TudorVisan/VasileBOT/hardware/README

v1.0
    - Complete BOM available at
      https://docs.google.com/spreadsheets/d/1lKYWt8WgzWd33CoD_yIm1lVHJigqv4kNXPXV9A-a3yk/edit?usp=sharing
