TudorVisan/VasileBOT/hardware/sensorboard.brd

## EAGLE design hardware/sensorboard.brd (2016-12-20)

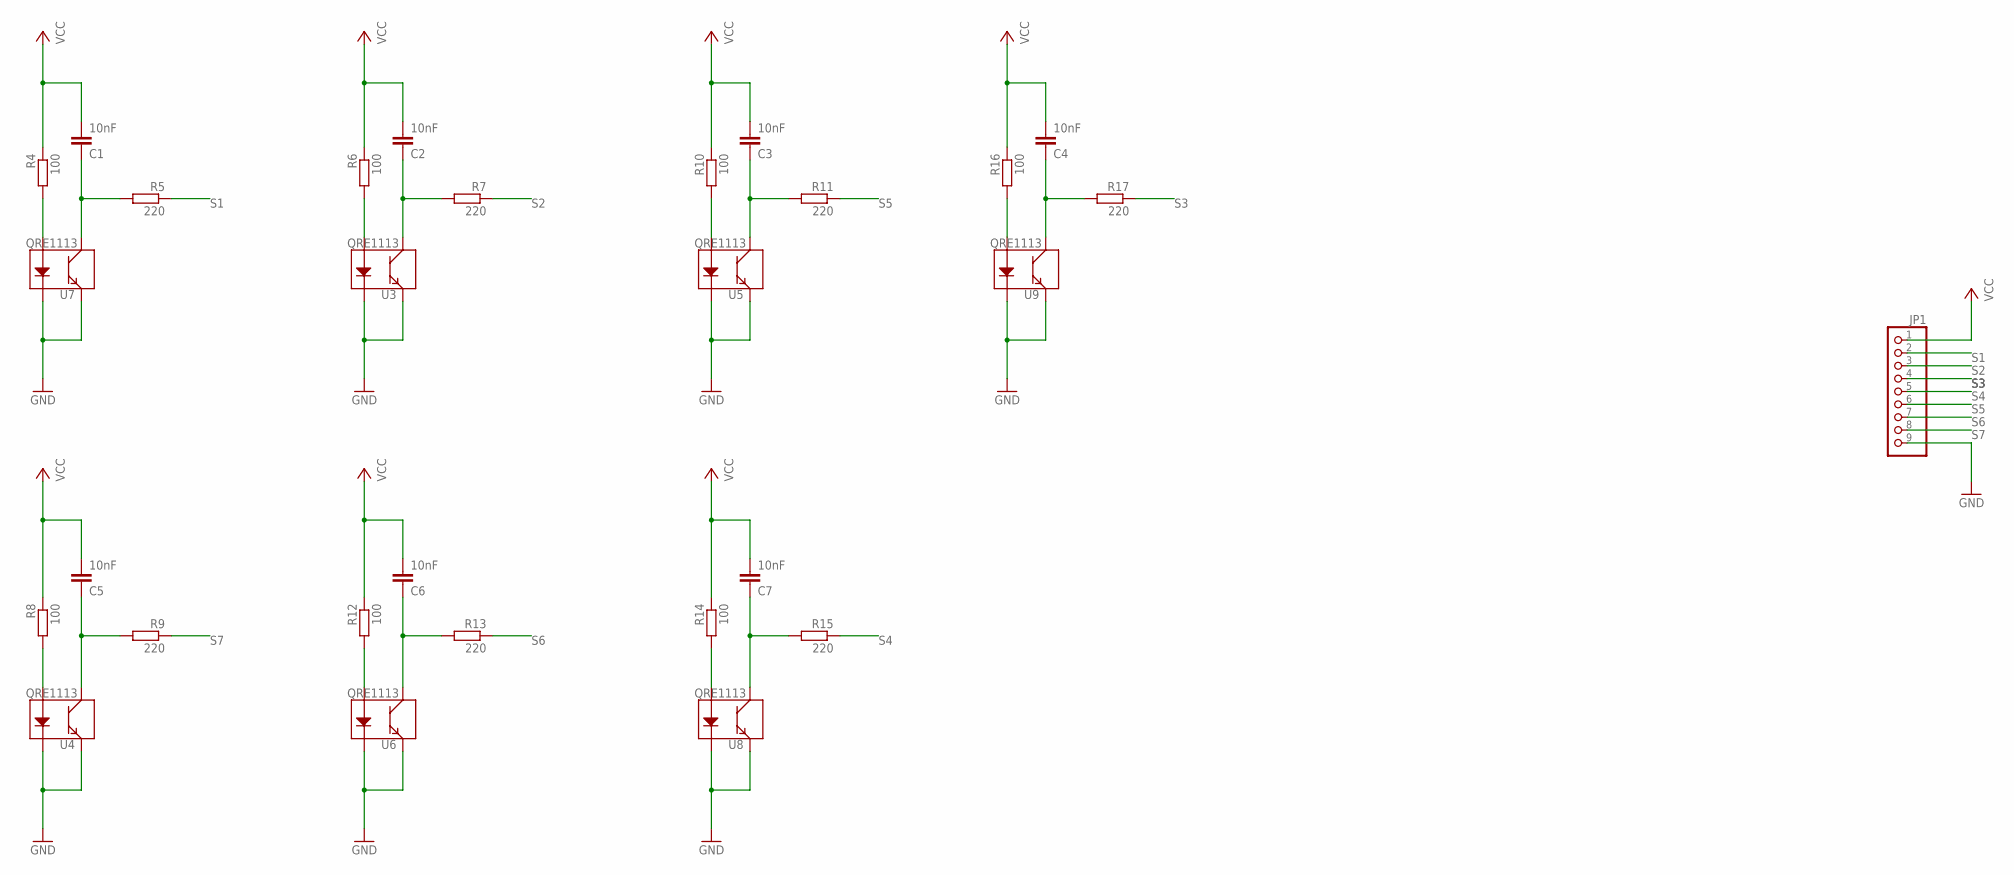
[picture p1: schematic sensorboard.sch]

Parts:
C1, C2, C3, C4, C5, C6, C7: 10nF; C0805K
JP1: PINHD-1X9; 1X09
R4, R6, R8, R10, R12, R14, R16: 100; M0805
R5, R7, R9, R11, R13, R15, R17: 220; M0805
U3, U4, U5, U6, U7, U8, U9: QRE1113

Connections:
GND: JP1.9, U3.2 (K), U3.4 (E), U4.2 (K), U4.4 (E), U5.2 (K), U5.4 (E), U6.2 (K), U6.4 (E), U7.2 (K), U7.4 (E), U8.2 (K), U8.4 (E), U9.2 (K), U9.4 (E)
unnamed: C1.1, R5.2, U7.3 (C)
unnamed: C2.1, R7.2, U3.3 (C)
unnamed: C3.1, R11.2, U5.3 (C)
unnamed: C4.1, R17.2, U9.3 (C)
unnamed: C7.1, R15.2, U8.3 (C)
unnamed: C6.1, R13.2, U6.3 (C)
unnamed: C5.1, R9.2, U4.3 (C)
unnamed: R4.2, U7.1 (A)
unnamed: R6.2, U3.1 (A)
unnamed: R8.2, U4.1 (A)
unnamed: R10.2, U5.1 (A)
unnamed: R12.2, U6.1 (A)
unnamed: R14.2, U8.1 (A)
unnamed: R16.2, U9.1 (A)
S1: JP1.2, R5.1
S2: JP1.3, R7.1
S3: JP1.4, R17.1
S4: JP1.5, R15.1
S5: JP1.6, R11.1
S6: JP1.7, R13.1
S7: JP1.8, R9.1
VCC: C1.2, C2.2, C3.2, C4.2, C5.2, C6.2, C7.2, JP1.1, R4.1, R6.1, R8.1, R10.1, R12.1, R14.1, R16.1

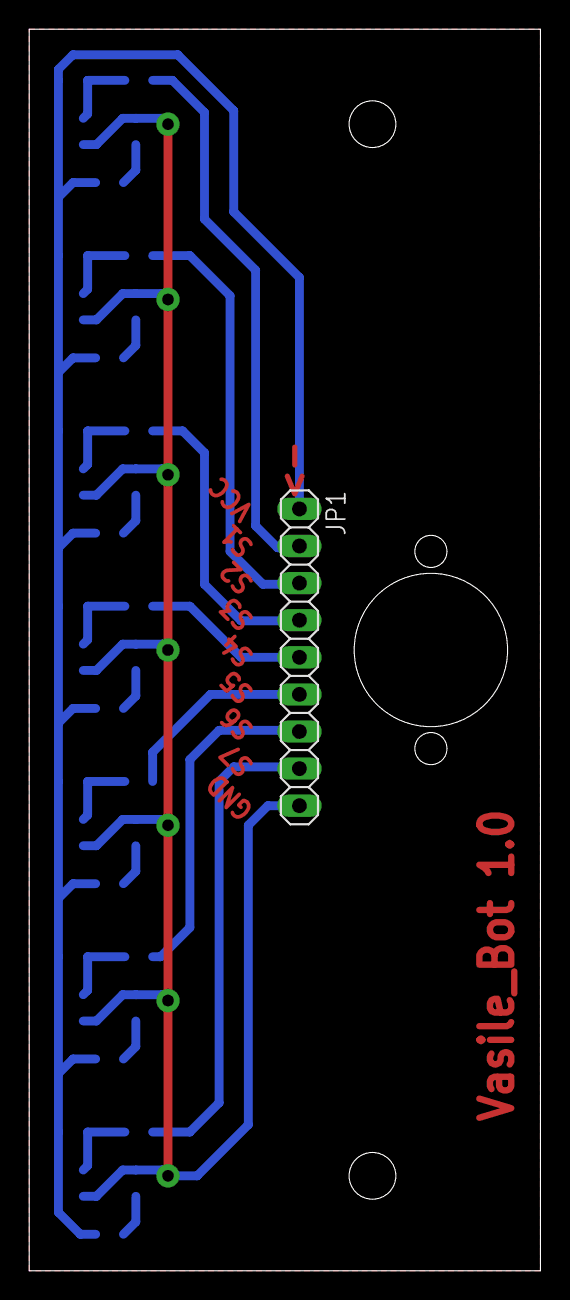
[picture p2: board sensorboard.brd from above]

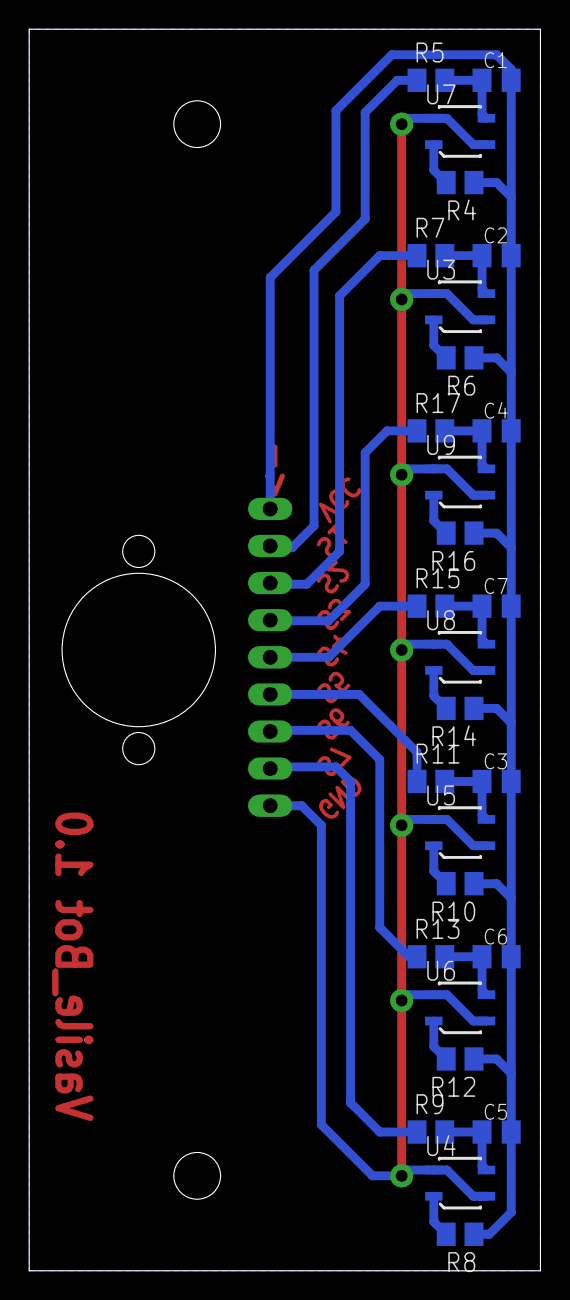
[picture p3: board sensorboard.brd from below]

Board: 2 copper layers, 35.0 x 85.0 mm, 29 parts (28 on the bottom side), 23 nets.
