TudorVisan/VasileBOT/hardware/motherboard.brd

## EAGLE design hardware/motherboard.brd (2016-12-20)

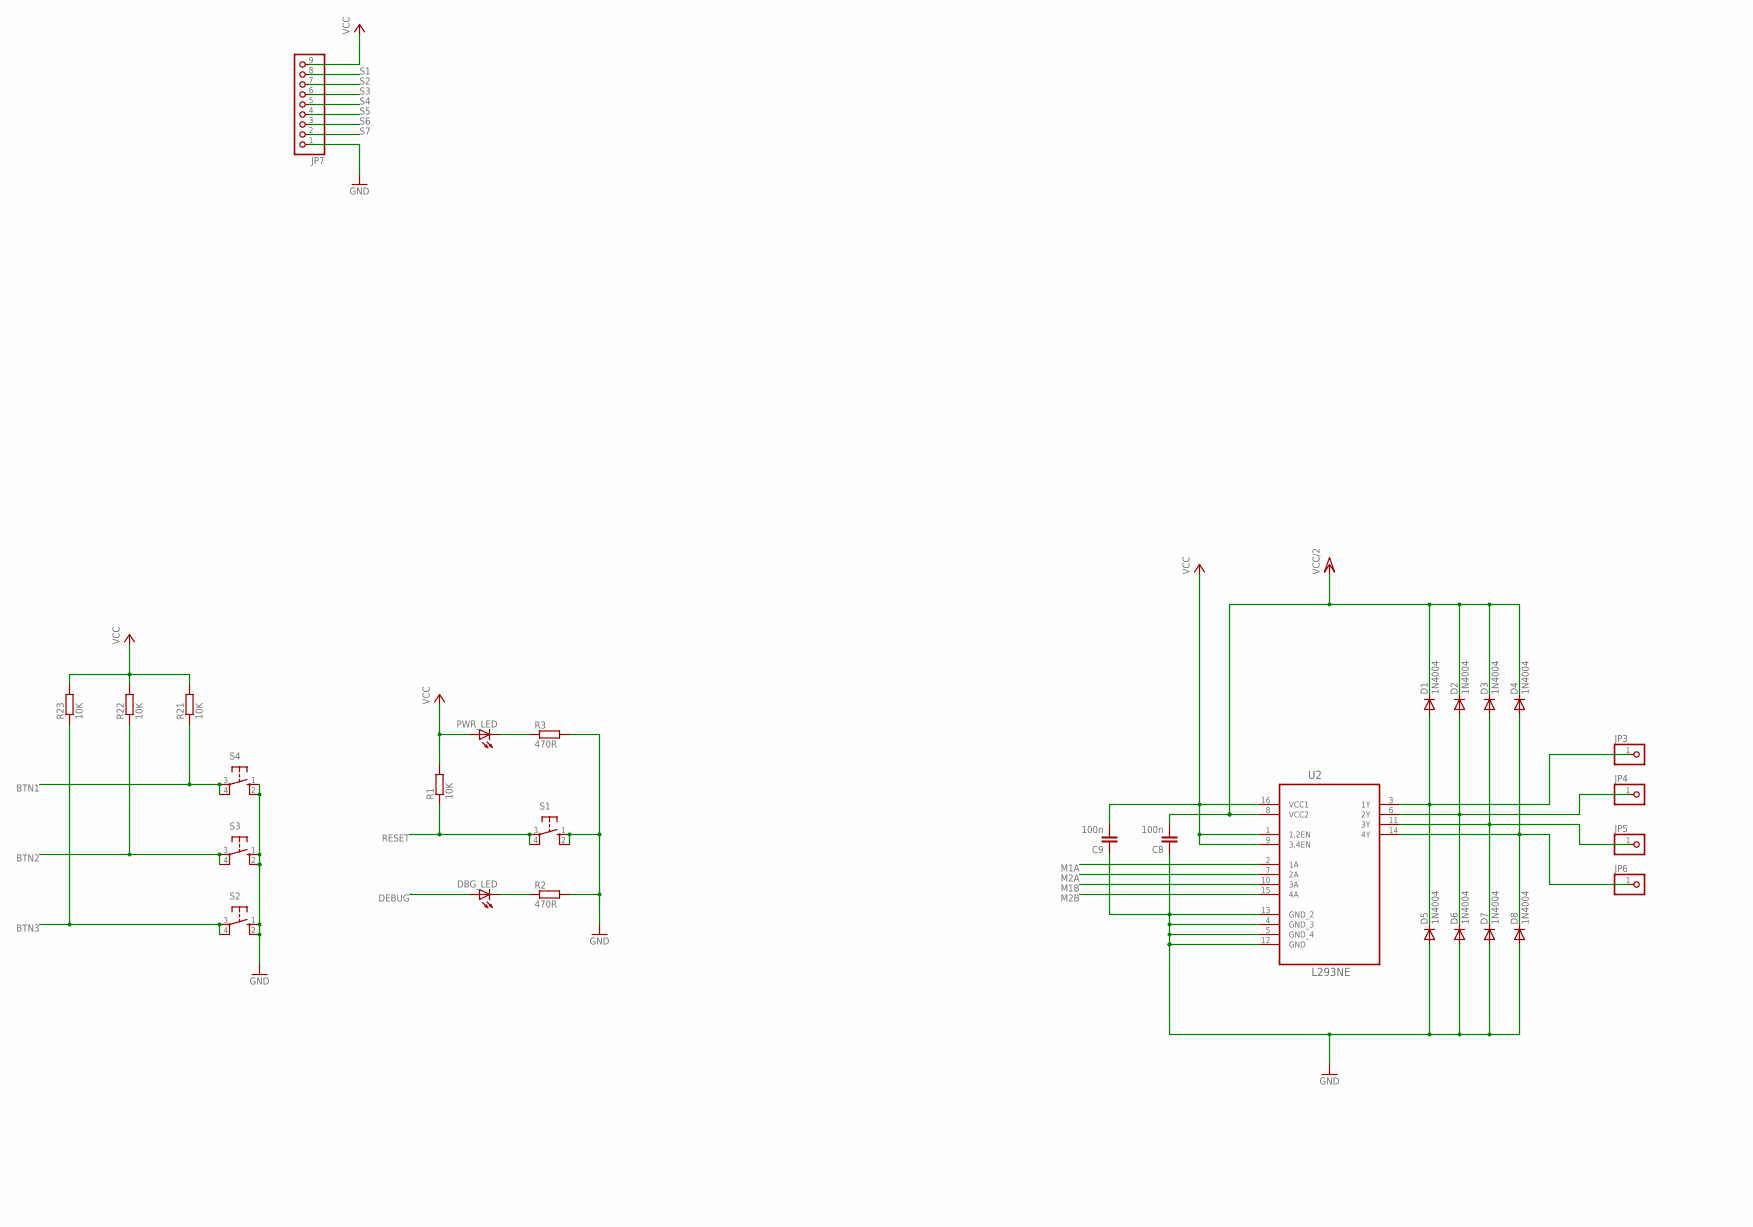
[picture p4: schematic motherboard.sch, part in row 1, column 1]

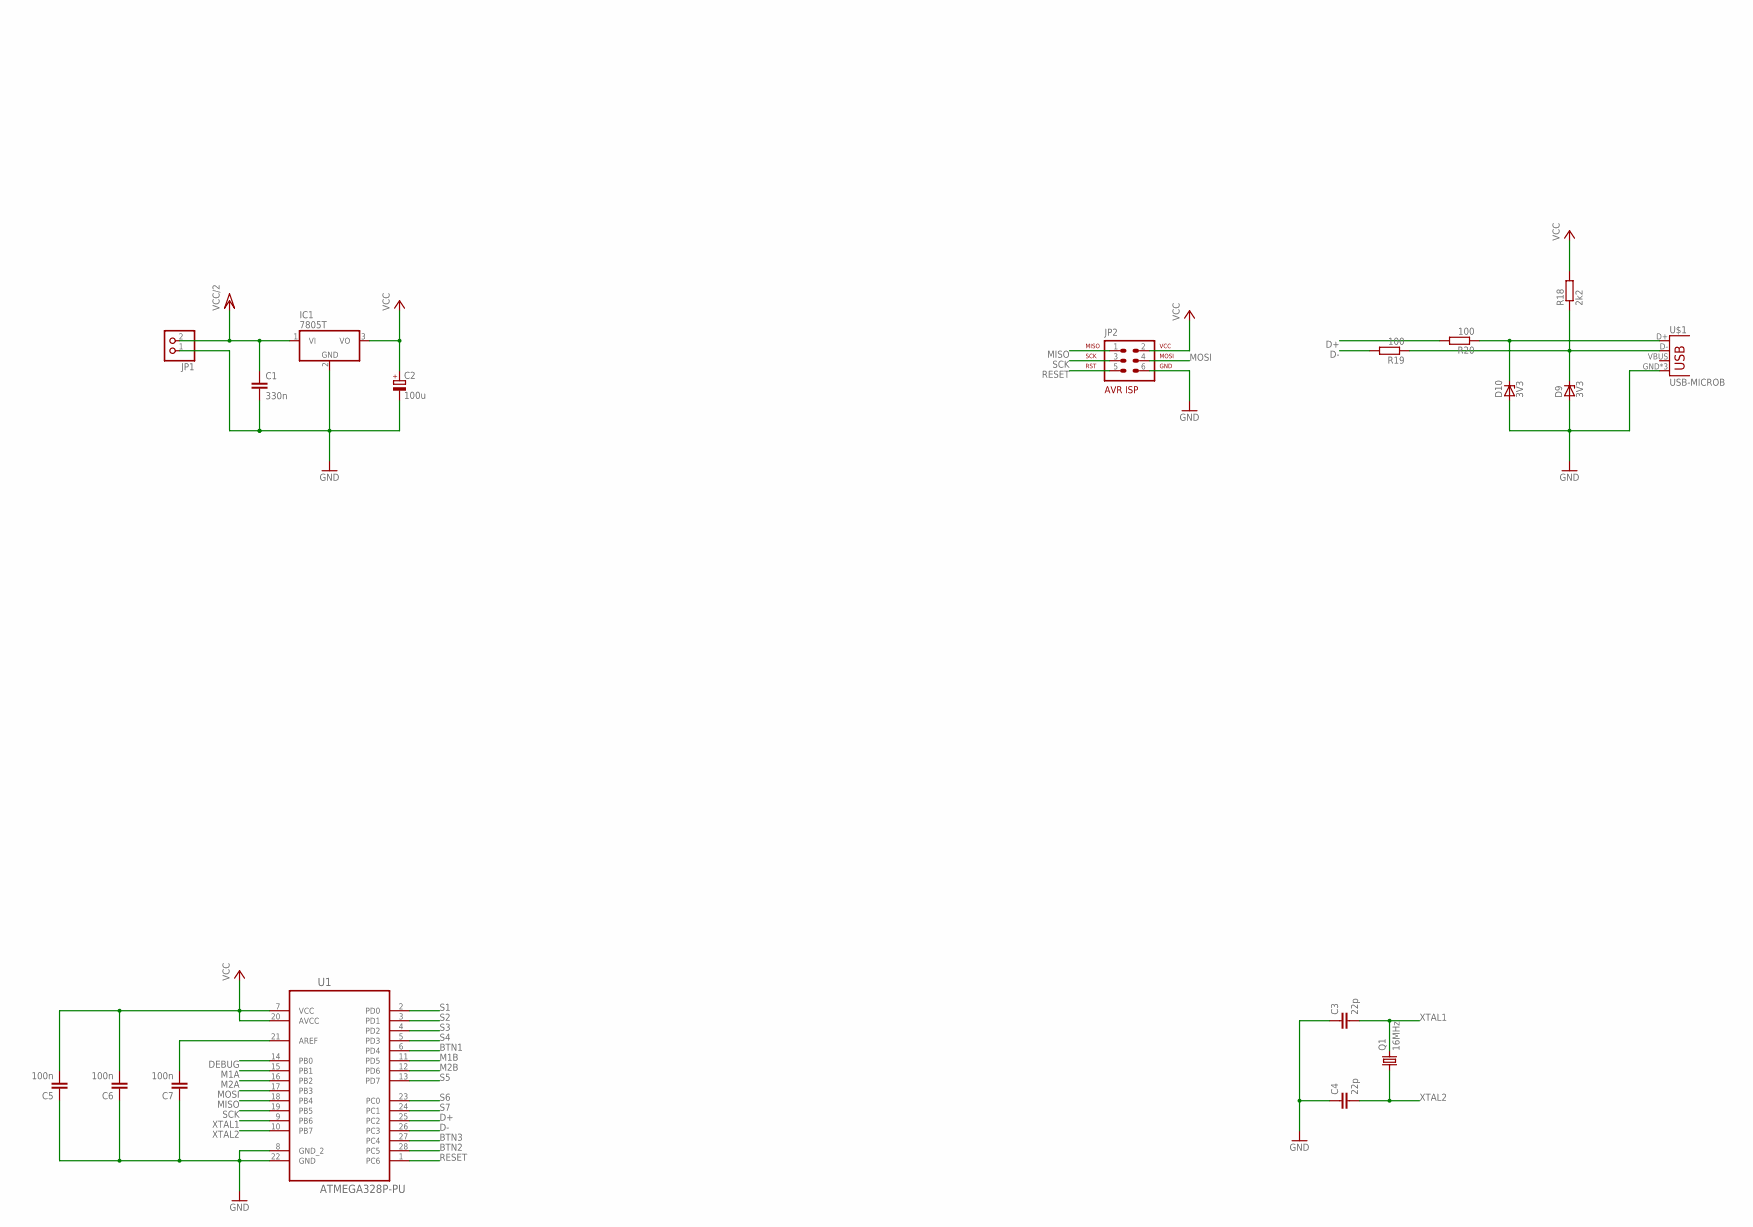
[picture p5: schematic motherboard.sch, part in row 2, column 1]

Parts:
C1: 330n; C0805K
C2: 100u; E2,5-5
C3, C4: 22p; C0805K
C5, C6, C7, C8, C9: 100n; C0805K
D1, D2, D3, D4, D5, D6, D7, D8: 1N4004; DO41-10
D9, D10: 3V3; DO41Z10
DBG_LED: LED5MM
IC1: 7805T; TO220H
JP1: PINHD-1X2; 1X02
JP2: AVR-ISP-6VERT; AVR-ISP-6
JP3, JP4, JP5, JP6: PINHD-1X1; 1X01
JP7: PINHD-1X9; 1X09
PWR_LED: LED5MM
Q1: 16MHz; HC49/S
R1, R21, R22, R23: 10K; M0805
R2, R3: 470R; M0805
R18: 2k2; M0805
R19, R20: 100; M0805
S1, S2, S3, S4: 10-XX; B3F-10XX
U1: ATMEGA328P-PU; DIP254P762X457-28
U2: L293NE; DIP254P762X508-16
U$1: USB-MICROB

Connections:
BTN1: R21.1, S4.3, S4.4 (P1), U1.6 (PD4)
BTN2: R22.1, S3.3, S3.4 (P1), U1.28 (PC5)
BTN3: R23.1, S2.3, S2.4 (P1), U1.27 (PC4)
D+: R20.2, U1.25 (PC2)
D-: R19.2, U1.26 (PC3)
DEBUG: DBG_LED.A, U1.14 (PB0)
GND: C1.2, C2.-, C3.1, C4.1, C5.1, C6.1, C7.1, C8.1, C9.1, D5.A, D6.A, D7.A, D8.A, D9.A, D10.A, IC1.2 (GND), JP1.1, JP2.6, JP7.1, R2.2, R3.2, S1.1 (S), S1.2 (S1), S2.1 (S), S2.2 (S1), S3.1 (S), S3.2 (S1), S4.1 (S), S4.2 (S1), U1.8 (GND_2), U1.22 (GND), U2.4 (GND_3), U2.5 (GND_4), U2.12 (GND), U2.13 (GND_2), U$1.GND, U$1.MT1 (GND), U$1.MT2 (GND)
M1A: U1.15 (PB1), U2.2 (1A)
M1B: U1.11 (PD5), U2.10 (3A)
M2A: U1.16 (PB2), U2.7 (2A)
M2B: U1.12 (PD6), U2.15 (4A)
MISO: JP2.1, U1.18 (PB4)
MOSI: JP2.4, U1.17 (PB3)
unnamed: PWR_LED.K (C), R3.1
unnamed: DBG_LED.K (C), R2.1
unnamed: C7.2, U1.21 (AREF)
unnamed: D1.A, D5.C, JP3.1, U2.3 (1Y)
unnamed: D2.A, D6.C, JP4.1, U2.6 (2Y)
unnamed: D3.A, D7.C, JP5.1, U2.11 (3Y)
unnamed: D4.A, D8.C, JP6.1, U2.14 (4Y)
unnamed: D9.C, R18.1, R19.1, U$1.D-
unnamed: D10.C, R20.1, U$1.D+
RESET: JP2.5, R1.1, S1.3, S1.4 (P1), U1.1 (PC6)
S1: JP7.8, U1.2 (PD0)
S2: JP7.7, U1.3 (PD1)
S3: JP7.6, U1.4 (PD2)
S4: JP7.5, U1.5 (PD3)
S5: JP7.4, U1.13 (PD7)
S6: JP7.3, U1.23 (PC0)
S7: JP7.2, U1.24 (PC1)
SCK: JP2.3, U1.19 (PB5)
VCC: C2.+, C5.2, C6.2, C9.2, IC1.3 (VO), JP2.2, JP7.9, PWR_LED.A, R1.2, R18.2, R21.2, R22.2, R23.2, U1.7 (VCC), U1.20 (AVCC), U2.1 (1,2EN), U2.9 (3,4EN), U2.16 (VCC1)
VCC/2: C1.1, C8.2, D1.C, D2.C, D3.C, D4.C, IC1.1 (VI), JP1.2, U2.8 (VCC2)
XTAL1: C3.2, Q1.2, U1.9 (PB6)
XTAL2: C4.2, Q1.1, U1.10 (PB7)

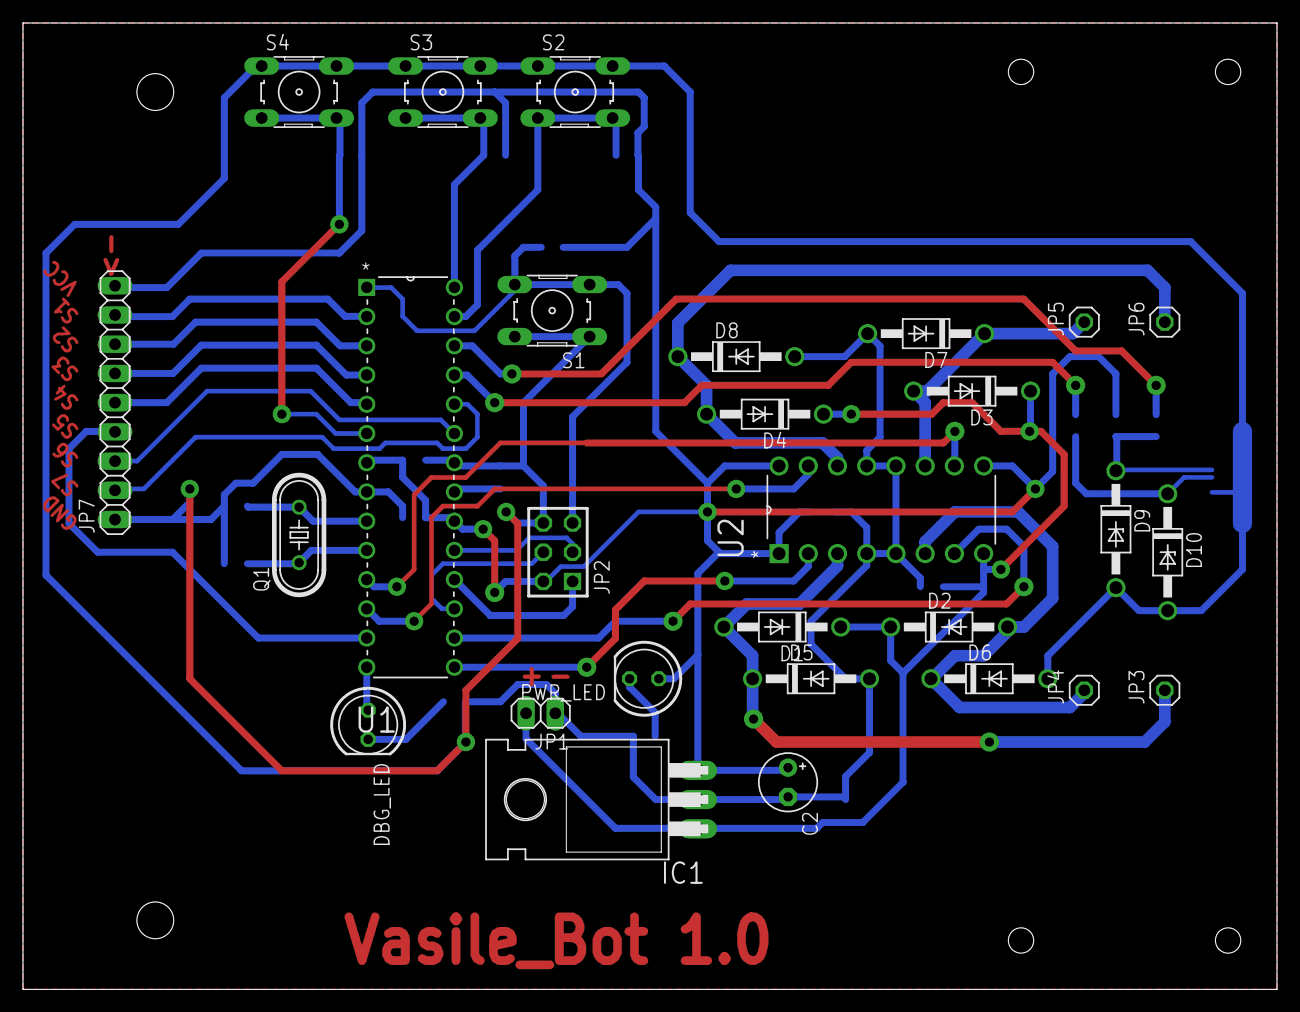
[picture p6: board motherboard.brd from above]

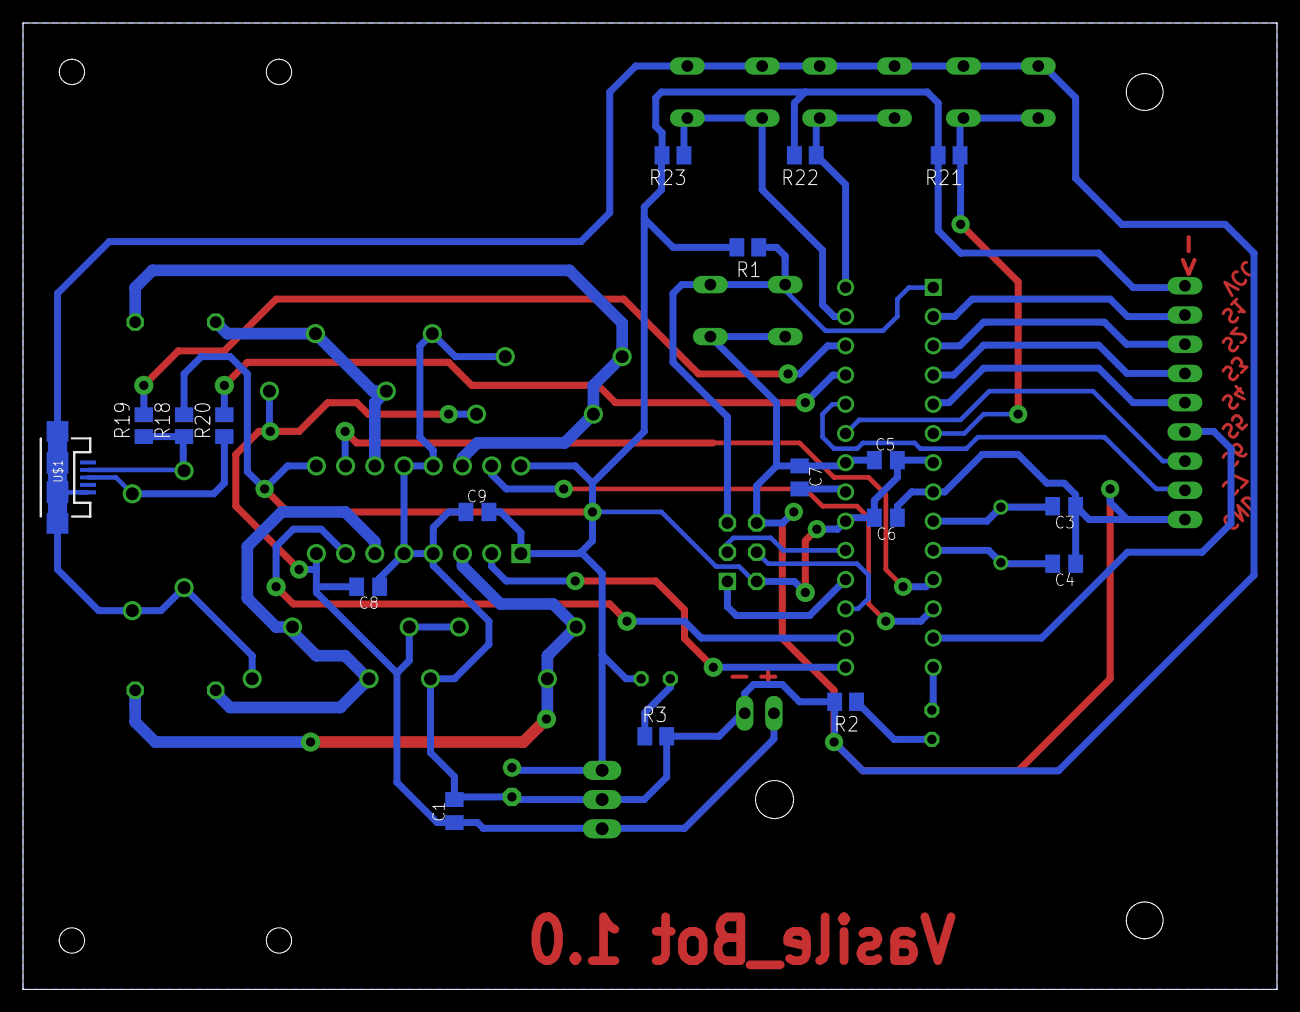
[picture p7: board motherboard.brd from below]

Board: 2 copper layers, 109.0 x 84.0 mm, 46 parts (18 on the bottom side), 35 nets.
