TudorVisan/VasileBOT/(commit log)

2016-05-18 added hardware
    [supply.sch, supply1.brd, supply1.sch]
2016-05-18 Added button functions.
    LED button frequencies may now vary.
2016-05-18 Removed and renamed hardware files.
    [motherboard.brd, motherboard.sch, supply.sch]
2016-05-18 Added a new board wich contains sensors.
    Modified motherboard and removed sensors. Moved them to a new separate
    board.
    [motherboard.sch, sensorboard.brd, sensorboard.sch]
2016-05-18 Added pin header to motherboard. Fixed all wire connection from motherboard.
    [motherboard.brd, motherboard.sch]
2016-05-25 Added functions to initialize and read sensors.
2016-05-25 Added motor init and macros.
2016-05-25 Added capacitors to sensor board. Fixed routing.
    [motherboard.brd, motherboard.sch, sensorboard.brd, sensorboard.sch]
2016-09-29 Prepared stage for porting to Arduino UNO.
2016-09-29 Added config target to makefile for configuring the board to be used.
2016-09-29 Added Arduino UNO Rev.3 schematics for reference.
    [arduino_Uno_Rev3-02-TH.brd, arduino_Uno_Rev3-02-TH.sch]
2016-10-11 Removed schematics for Arduino Uno. Added schematics for Arduino Leonardo and datasheet for ATmega32U4.
    [Arduino_Leonardo-REV3b.brd, Arduino_Leonardo-REV3b.sch, arduino_Uno_Rev3-02-TH.brd, arduino_Uno_Rev3-02-TH.sch]
2016-10-11 Fixed motherboard errors.
    [motherboard.brd, motherboard.sch]
2016-10-11 Added motherboard length measurement.
    [motherboard.brd]
2016-10-11 Added dimension to sensorboard.
    [sensorboard.brd]
2016-10-11 Added halls to motherboard. Added dimension.
    [motherboard.brd, motherboard.sch, sensorboard.brd]
2016-10-11 Modified header and makefile for Arduino test.
2016-10-18 Added ball caster. Added halls for ball caster. Fixed mounting halls.
    [sensorboard.brd]
2016-10-18 Fixed motors space. Added motors halls.
    [motherboard.brd, motherboard.sch]
2016-10-18 Added an arduino only source file for testing and upload target to Makefile
2016-10-24 Add files via upload
    Added links for ball caster, motors, wheels and battery.
2016-10-24 Added links for motors, battery, wheels and ball caster.
2016-11-01 Added custom MCU, board name and upload command for each board. Removed backup makefile. Added bootloadHID uploader.
2016-11-01 Made 2 source files for different boards and board library.
2016-11-01 Fixed makefile. Fixed compilation errors.
    [board_arduino_leonardo.c, board_vasilebot_v1.c]
2016-11-01 Fixed LED blinking for Arduino Leonardo.
    [board_arduino_leonardo.c]
2016-11-08 Added partlists for boards.
    [motherboard.brd, motherboard.sch]
2016-11-08 Disabled USB controller for Arduino Leonardo.
2016-11-13 Remove component list. Added link to BOM in a README file for hardware.
2016-11-13 Beautified sensorboard and motherboard schematics. Fixed motherboard angle error.
    [motherboard.brd, motherboard.sch, sensorboard.brd, sensorboard.sch]
2016-11-15 Added volatile variables, tested buttons and sensors, added power led for button3.
2016-11-22 Modified motors initialisation for Arduino Board.
2016-12-20 Added pdf files to be ignored.
    [motherboard.brd, sensorboard.brd]
